AdithyaSM31/Precision-Agriculture-Monitoring-Quadruped-Robot-Dog/report/figures/photo_robot.jpg

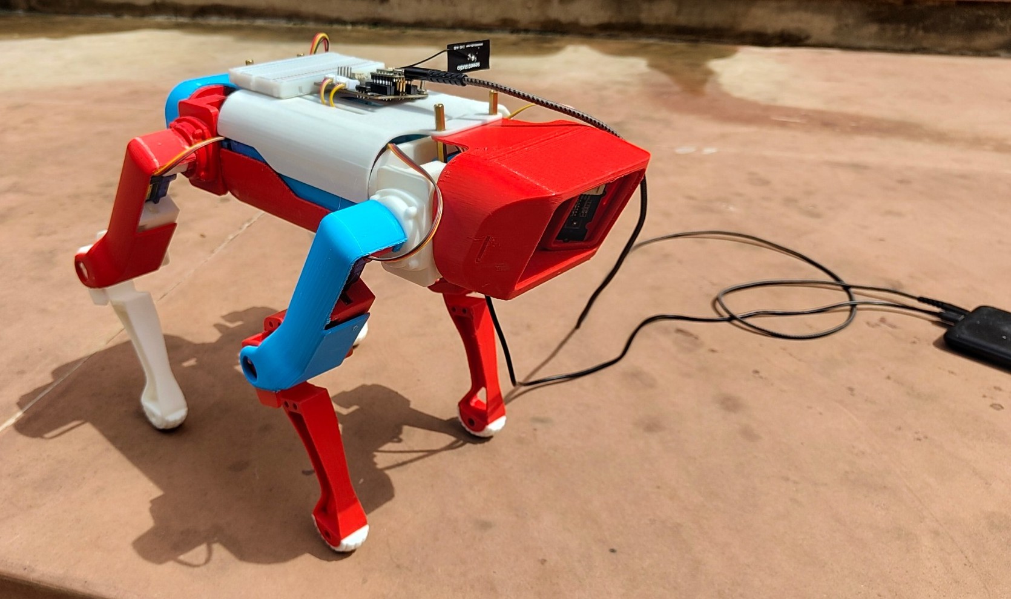
report/figures/photo_robot.jpg
