AdithyaSM31/Precision-Agriculture-Monitoring-Quadruped-Robot-Dog/report/figures/photo_chassis.jpg

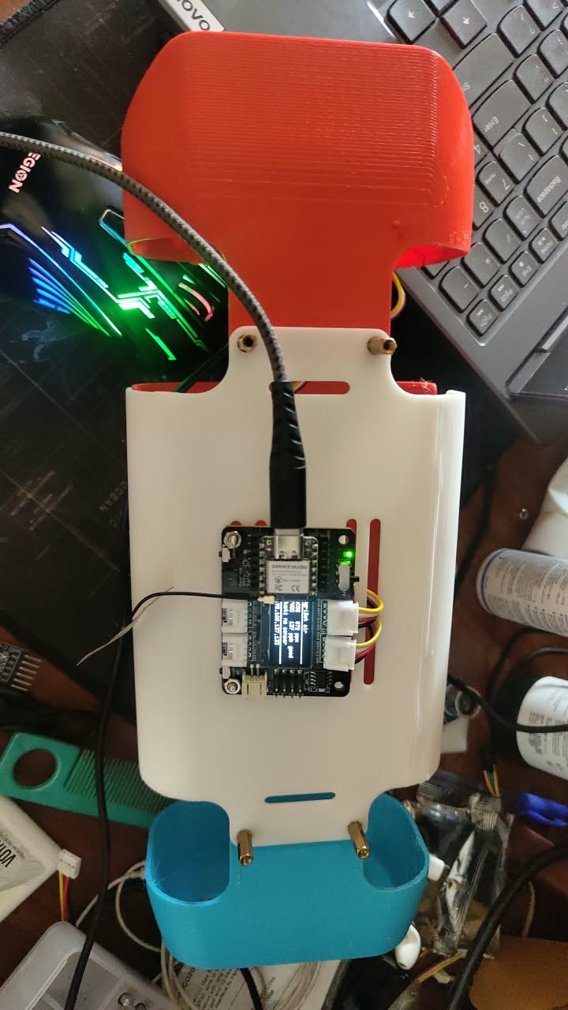
report/figures/photo_chassis.jpg
