AdithyaSM31/Precision-Agriculture-Monitoring-Quadruped-Robot-Dog/paper/figures/fig_gate.png

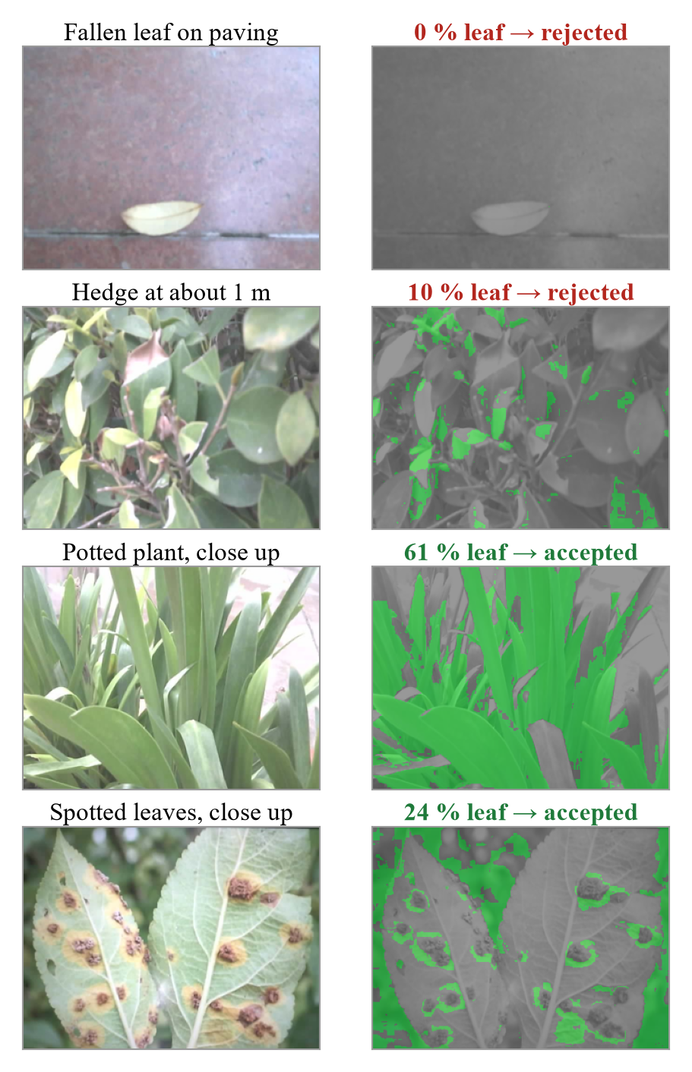
paper/figures/fig_gate.png
