AdithyaSM31/Precision-Agriculture-Monitoring-Quadruped-Robot-Dog/System_Architecture.png

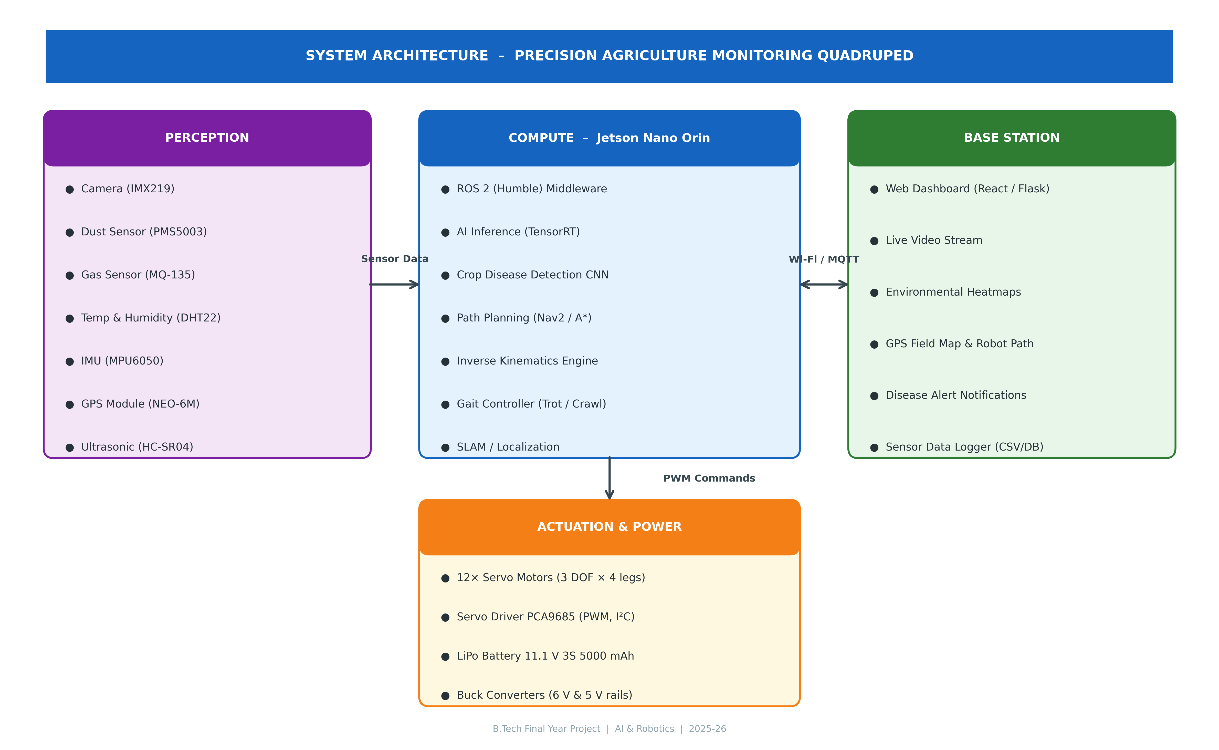
System_Architecture.png
