AdithyaSM31/Precision-Agriculture-Monitoring-Quadruped-Robot-Dog/custom_parts/T_cover_jetson_mg_ASSEMBLY.stl

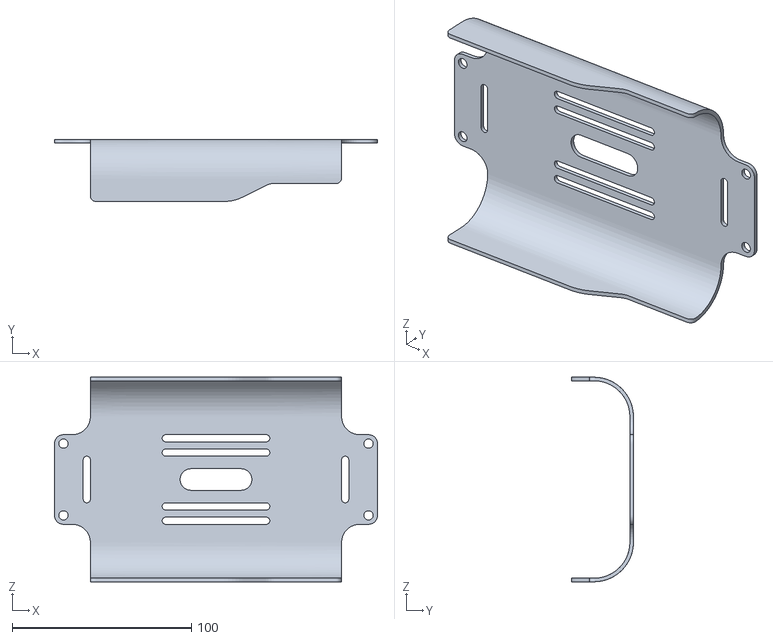
[picture p98: CAD file, 2026-09-16]
custom_parts/T_cover_jetson_mg_ASSEMBLY.stl
180.0 x 34.5 x 114.0
