AdithyaSM31/Precision-Agriculture-Monitoring-Quadruped-Robot-Dog/3D_PRINT_READY/03_JETSON_MOUNT/x1_jetson_deck.stl

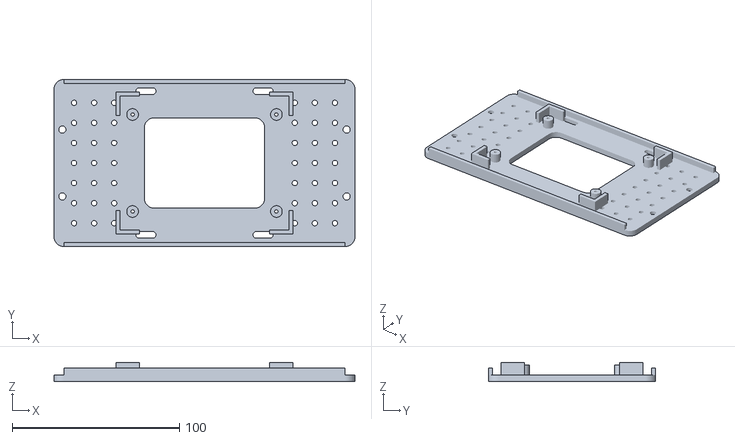
[picture p99: CAD file, 2026-09-16]
3D_PRINT_READY/03_JETSON_MOUNT/x1_jetson_deck.stl
180.0 x 100.0 x 11.5
