AdithyaSM31/Precision-Agriculture-Monitoring-Quadruped-Robot-Dog/custom_parts/sgp30_bracket.stl

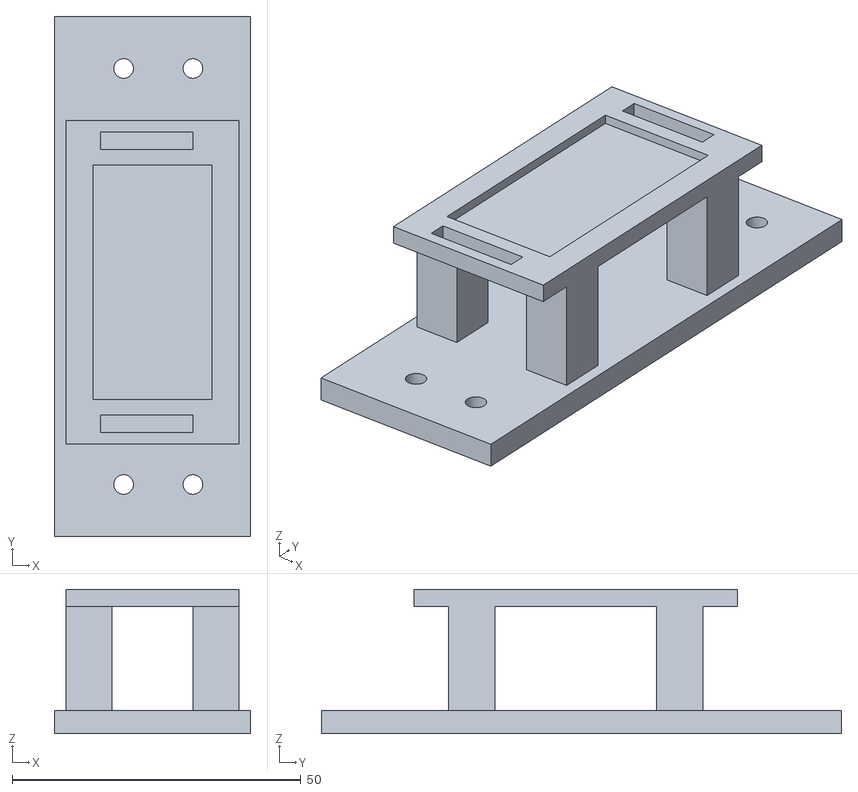
[picture p100: CAD file, 2026-09-16]
custom_parts/sgp30_bracket.stl
34.0 x 90.0 x 25.0
