AdithyaSM31/Precision-Agriculture-Monitoring-Quadruped-Robot-Dog/(list of files, cad)

Other CAD files:
custom_parts/T_cover_jetson_mg.stl
