AdithyaSM31/Precision-Agriculture-Monitoring-Quadruped-Robot-Dog/simulation/results/frame_02_row_gap_1.png

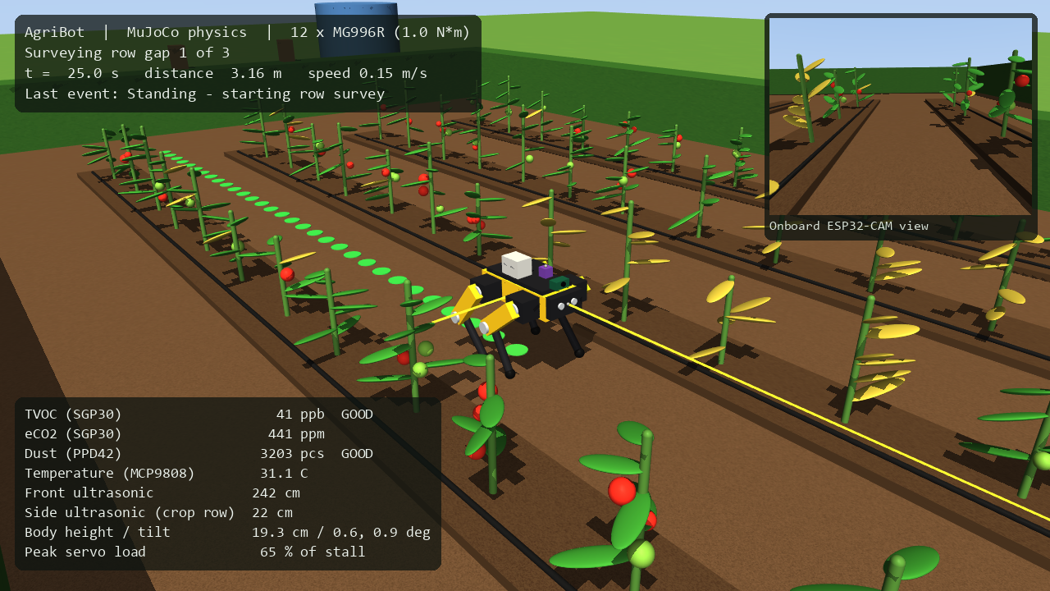
simulation/results/frame_02_row_gap_1.png
