AdithyaSM31/Precision-Agriculture-Monitoring-Quadruped-Robot-Dog/simulation/results/frame_05_survey_done.png

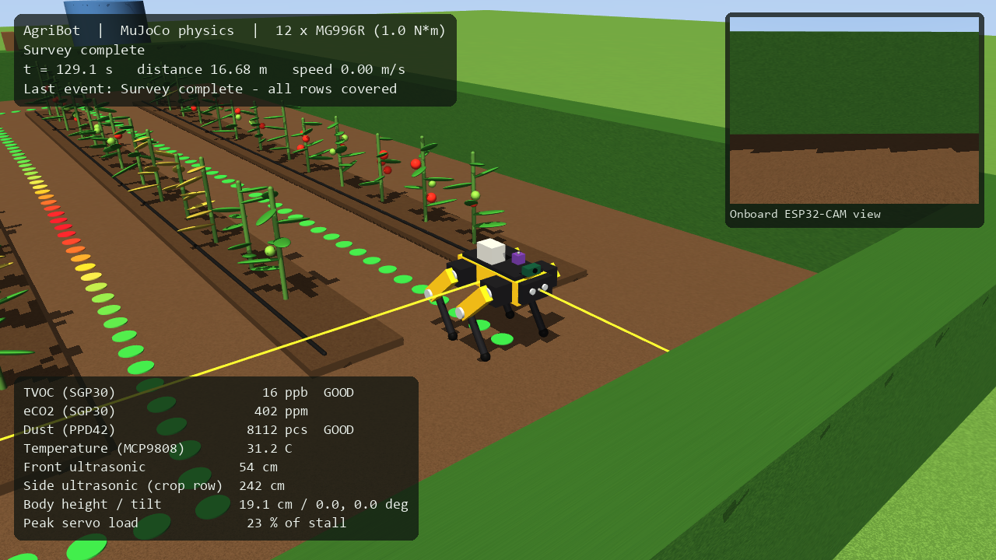
simulation/results/frame_05_survey_done.png
