AdithyaSM31/Precision-Agriculture-Monitoring-Quadruped-Robot-Dog/(commit log)

2026-09-16 Initial commit: printed chassis, custom mounts, simulators and ROS 2 package
    Mechanical
    - 35 print-ready STLs (3D_PRINT_READY), quantities encoded in filenames
    - Four team-designed parts: external Jetson deck, modified top cover, and
    upright PPD42 / raised SGP30 sensor brackets, with parametric generators
    - All verified watertight with 0.0000 cm3 interference against the deck and
    the Jetson envelope
    Kinematics and simulation
    - Closed-form 3-DOF inverse kinematics, validated against forward kinematics
    to 5.7e-17 m across the workspace
    - Browser simulator with quasi-static physics: centre of mass, support
    polygon, solved foot loads and per-joint torque (1.7574 kg mass model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
2026-10-12 Add field monitoring payload: sensor node, camera node and dashboard
    - XIAO ESP32-S3 sensor node: SGP30 gas, MCP9808 temperature, PPD42 dust
    and two HC-SR04 ultrasonics (obstacle + canopy height), OLED pages,
    buzzer alerts, missing-sensor detection, Wi-Fi diagnostics
    - ESP32-CAM camera node: MJPEG stream on :81 plus /capture, registers
    itself with the dashboard at boot
    - Flask dashboard: live readings and charts, relayed ~18 fps video,
    MobileNetV2 leaf-disease tagging stamped with sensor context, CSV log
    - Wiring diagram page with breadboard divider layout and checklist
    Wi-Fi credentials stay in git-ignored secrets.h files.
2026-10-12 Add MuJoCo field simulation: autonomous row survey with physics
    - Robot built from the measured chassis (140 x 78 mm hips, 111/125 mm legs,
    1.35 kg) with 12 position servos torque-limited to MG996R stall (1.0 N*m)
    - Leg IK verified against MuJoCo forward kinematics (1,280 targets, 0 mm error)
    - Trot gait with footholds centred on the measured centre of mass, which sits
    12 mm aft because the knees point backward; without it the robot fell in
    every gait setting tried
    - Tomato field with a diseased patch: the robot surveys all row gaps, detects
    row ends with the front ultrasonic, and maps a VOC plume with the SGP30 model
    - Interactive viewer with sensor panels and onboard camera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
2026-10-21 Add project report, journal paper and review decks; trim dashboard to four sensor cards
    - report/: generator for the 86-page project report (content, references,
    figures, Word finalisation script) with the built .docx and .pdf
    - paper/: IEEE-style journal paper generator, figures and built .docx/.pdf
    - presentation/: pre-final and final review deck builders, images and videos;
    final review deck organised around the six panel rubric criteria
    - Dashboard: drop the ultrasonic cards and CSV columns, rotate a day's CSV
    when its header changes, export the newest log, show leaf coverage
    - simulation/README: correct the speed-tracking range to 0.08-0.18 m/s
2026-10-21 Add servo controller, speaker notes and code walkthrough; correct stance advice
    - locomotion/servo_controller: ESP32 + PCA9685 controller for the 12 MG996R
    servos, porting the simulation's leg IK and trot (checked against the
    Python IK to 6e-6 rad); leg test, stand, sway, trot and calibration commands
    - presentation/speaker_notes.js: detailed notes for every slide, built into
    the final review deck; printable speaker-notes PDF
    - CODE_WALKTHROUGH.md: files, line numbers and talking points for showing
    the code to the panel
    - A taller stance with straighter legs, not a lower one, shortens the knee
    lever arm: corrected in the deck, paper and report
